MOSH-Insa-Toulouse/2021-2022_Dabadie_Labrousse/Application_Bluetooth_APK/Appli_BT.png

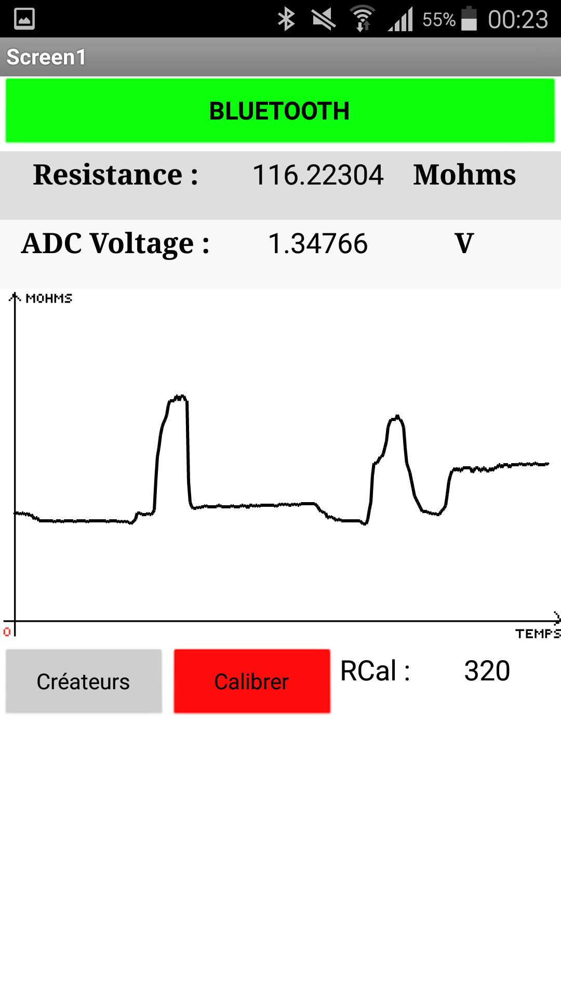
Application_Bluetooth_APK/Appli_BT.png
