MOSH-Insa-Toulouse/2021-2022_Dabadie_Labrousse/Application_Bluetooth_APK/Connexion_BT.PNG

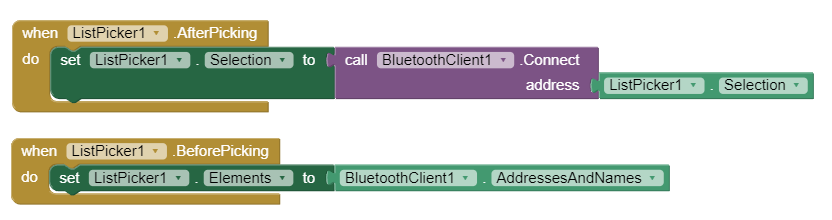
Application_Bluetooth_APK/Connexion_BT.PNG
