MOSH-Insa-Toulouse/2021-2022_Dabadie_Labrousse/Application_Bluetooth_APK/Graph_pix.png

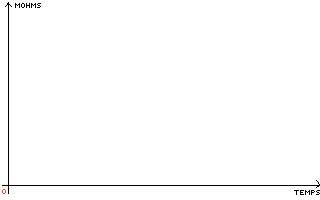
Application_Bluetooth_APK/Graph_pix.png
