MOSH-Insa-Toulouse/2021-2022_Dabadie_Labrousse/Application_Bluetooth_APK/Récupération_Valeurs.PNG

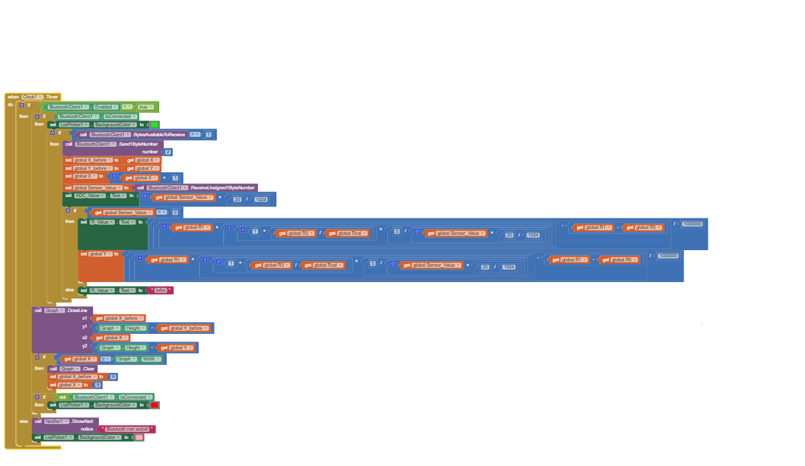
Application_Bluetooth_APK/Récupération_Valeurs.PNG
