MOSH-Insa-Toulouse/2021-2022_Dabadie_Labrousse/Banc_de_Test_Datasheet/Banc de test.xlsx

 | Capteur B
 | Epaisseur (cm) | Rayon(cm) | Résistance (Mohms) | R0 | Déformation | Delta R/R0 | 79.19666667
 | 0.03 | 3 | 59.3 | 63 | 0.005 | 0.06239460371 |  | 79.58
 | 0.03 | 2.5 | 57.5 | 63 | 0.006 | 0.09565217391 |  | 78.28
COMPRESSION | 0.03 | 2 | 55.5 | 63 | 0.0075 | 0.1351351351 |  | 78.71
 | 0.03 | 1.5 | 53.7 | 63 | 0.01 | 0.1731843575 |  | 80.02
 | 0.03 | 1 | 51.3 | 63 | 0.015 | 0.2280701754 |  | 80.02
 | -0.03 | 3 | 66 | 63 | -0.005 | -0.04761904762 |  | 79.58
 | -0.03 | 2.5 | 68 | 63 | -0.006 | -0.07936507937 |  | 77.86
TENSION | -0.03 | 2 | 69 | 63 | -0.0075 | -0.09523809524 |  | 79.14
 | -0.03 | 1.5 | 71.2 | 63 | -0.01 | -0.1301587302 |  | 79.58
 | -0.03 | 1 | 73 | 63 | -0.015 | -0.1587301587
 | Capteur HB
 | Epaisseur (cm) | Rayon(cm) | Résistance (Mohms) | R0 | Déformation | Delta R/R0
 | 0.03 | 3 | 185 | 194 | 0.005 | 0.04864864865
 | 0.03 | 2.5 | 186 | 200 | 0.006 | 0.0752688172
COMPRESSION | 0.03 | 2 | 173 | 191 | 0.0075 | 0.1040462428
 | 0.03 | 1.5 | 160 | 185 | 0.01 | 0.15625
 | 0.03 | 1 | 152 | 186 | 0.015 | 0.2236842105
 | -0.03 | 3 | 125 | 117 | -0.005 | -0.064
TENSION | -0.03 | 2.5 | 125 | 115 | -0.006 | -0.08
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
